unixvoid/SquidTX-Nano-ELRS/docs/images/schematic.png

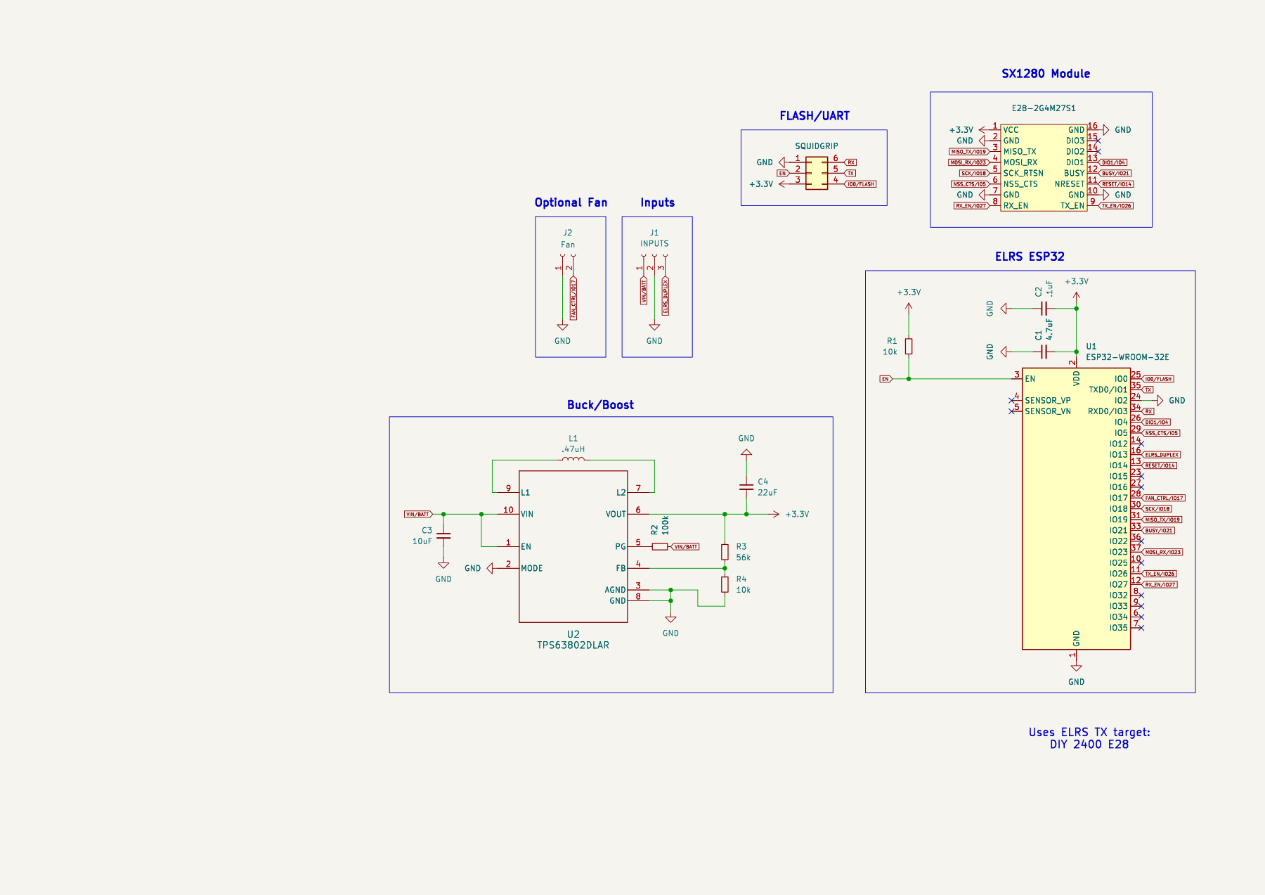
docs/images/schematic.png
