unixvoid/SquidTX-Nano-ELRS/hardware/squidtx_nano.kicad_pcb

## KiCad design hardware/squidtx_nano.kicad_pcb (2026-10-14)

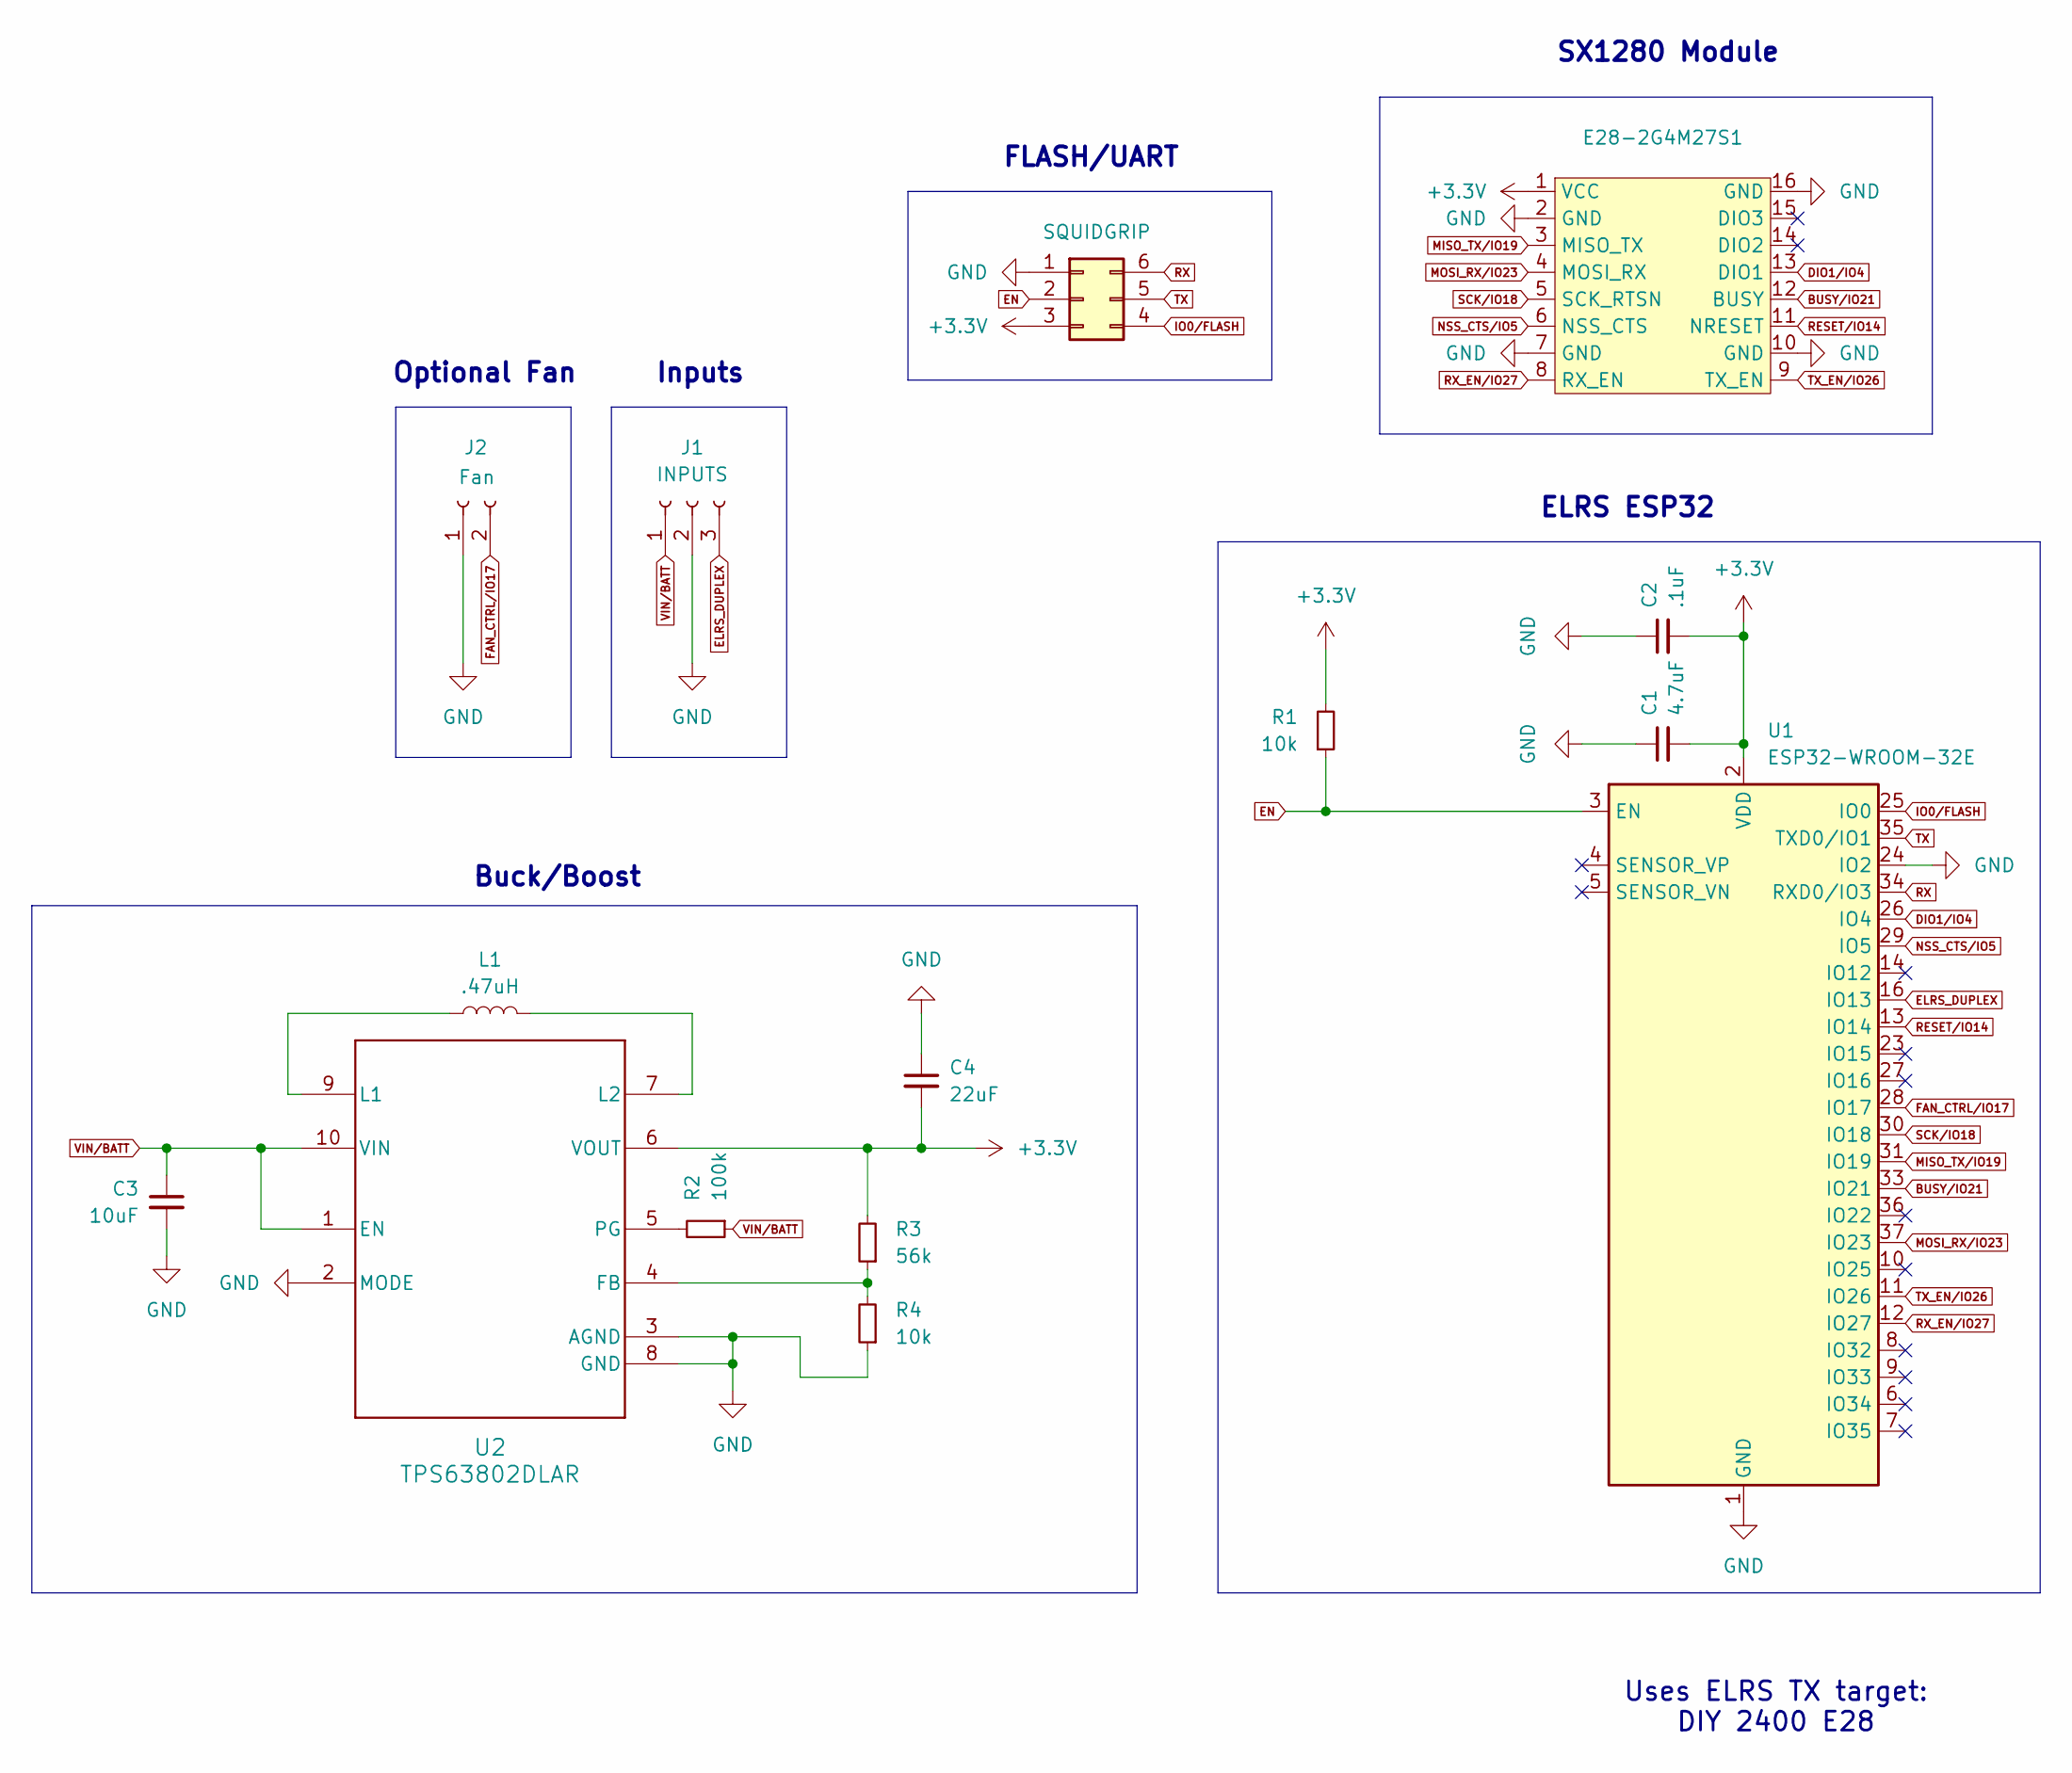
[picture p10: schematic squidtx_nano.kicad_sch, SquidTX Nano]

Parts:
C1: 4.7uF; C_0805_2012Metric
C2: .1uF; C_0805_2012Metric
C3: 10uF; C_0805_2012Metric
C4: 22uF; C_0805_2012Metric
E28-2G4M27S1: E28-2G4M27S
J1: INPUTS; PinHeader_1x03_P2.54mm_Vertical
J2: Fan; PinHeader_1x02_P2.54mm_Vertical
L1: .47uH; L_1210_3225Metric
R1, R4: 10k; R_0805_2012Metric
R2: 100k; R_0805_2012Metric
R3: 56k; R_0805_2012Metric
SG1: SQUIDGRIP; squidgrip
U1: ESP32-WROOM-32E; ESP32-WROOM-32D
U2: TPS63802DLAR

Connections:
+3.3V: C1.2, C2.2, C4.2, E28-2G4M27S1.1 (VCC), R1.2, R3.2, SG1.3 (3.3v), U1.2 (VDD), U2.6 (VOUT)
BUSY/IO21: E28-2G4M27S1.12 (BUSY), U1.33 (IO21)
DIO1/IO4: E28-2G4M27S1.13 (DIO1), U1.26 (IO4)
ELRS_DUPLEX: J1.3, U1.16 (IO13)
EN: R1.1, SG1.2 (DTR), U1.3 (EN)
FAN_CTRL/IO17: J2.2, U1.28 (IO17)
GND: C1.1, C2.1, C3.2, C4.1, E28-2G4M27S1.2 (GND), E28-2G4M27S1.7 (GND), E28-2G4M27S1.10 (GND), E28-2G4M27S1.16 (GND), J1.2, J2.1, R4.1, SG1.1 (GND), U1.1 (GND), U1.15 (GND), U1.24 (IO2), U1.38 (GND), U1.39 (GND), U2.2 (MODE), U2.3 (AGND), U2.8 (GND)
IO0/FLASH: SG1.4 (RTS), U1.25 (IO0)
MISO_TX/IO19: E28-2G4M27S1.3 (MISO_TX), U1.31 (IO19)
MOSI_RX/IO23: E28-2G4M27S1.4 (MOSI_RX), U1.37 (IO23)
NSS_CTS/IO5: E28-2G4M27S1.6 (NSS_CTS), U1.29 (IO5)
unnamed: R3.1, R4.2, U2.4 (FB)
unnamed: L1.1, U2.9 (L1)
unnamed: L1.2, U2.7 (L2)
unnamed: R2.2, U2.5 (PG)
RESET/IO14: E28-2G4M27S1.11 (NRESET), U1.13 (IO14)
RX: SG1.6 (TXD), U1.34 (RXD0/IO3)
RX_EN/IO27: E28-2G4M27S1.8 (RX_EN), U1.12 (IO27)
SCK/IO18: E28-2G4M27S1.5 (SCK_RTSN), U1.30 (IO18)
TX: SG1.5 (RXD), U1.35 (TXD0/IO1)
TX_EN/IO26: E28-2G4M27S1.9 (TX_EN), U1.11 (IO26)
VIN/BATT: C3.1, J1.1, R2.1, U2.1 (EN), U2.10 (VIN)

Notes on the sheet:
Inputs
Optional Fan
FLASH/UART
SX1280 Module
Buck/Boost
ELRS ESP32
Uses ELRS TX target: DIY 2400 E28

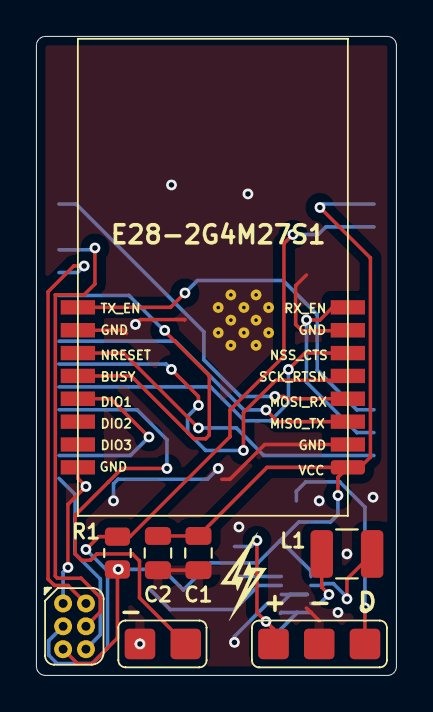
[picture p11: board squidtx_nano.kicad_pcb from above]

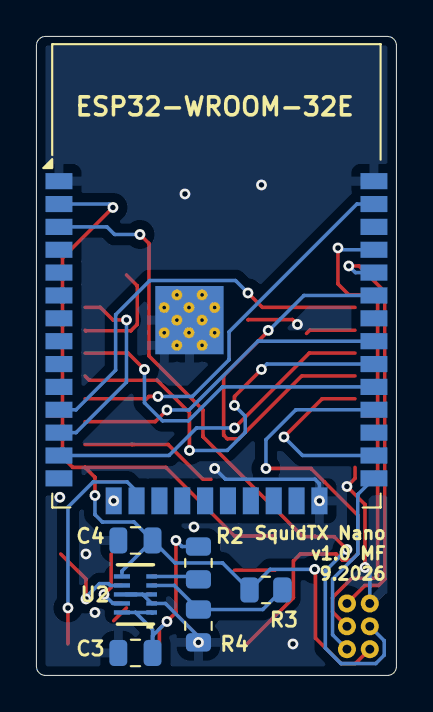
[picture p12: board squidtx_nano.kicad_pcb from below]

Board: 2 copper layers, 20.0 x 35.5 mm, 15 parts (7 on the bottom side), 22 nets.
